amiguser/pcb/template_atmega8/description.odt

Возможности

Тактирование (переключатель):

- Внутренний
- Внешний 8МГц

i2c – линия

RX-TX – линия

Входы аналоговые

Управление – кнопки\клавиатура.

Отображение – 7-сегментный, 1603 – дисплей.

Сигнализация – светодиоды, бузер.

Ввод – кнопки:

PB0-PB3

Вывод – leds:

PB5-PB7

Вывод – buzzer:

PB4
