amiguser/pcb/waterlock/controllerTFQP.ods

Id | Designator | Package | Quantity | Designation | Supplier and ref | Total | pads/driils | type
1 | R7,R8 | R_0805_HandSoldering | 2 | 10k | 0,8 | 1,6 | 2 | smd | 4
2 | BZ1 | Buzzer_12x9.5RM7.6 | 1 | Buzzer | 8 | 8 | 2 | th | 2
3 | C1,C3 | C_1206_HandSoldering | 2 | 10m | 1 | 2 | 2 | smd | 4
4 | D1 | D_SMA_Handsoldering | 2 | SS16 | 2 | 4 | 2 | smd | 4
5 | D3 | LED_D3.0mm | 1 | LowBatt | 1 | 1 | 2 | th | 2
6 | D4 | LED_D3.0mm | 1 | Flooding | 1 | 1 | 2 | th | 2
7 | J8 | Pin_Header_Straight_1x06_Pitch2.54mm | 1 | Conn_01x06 | 0,6 | 0,6 | 6 | th | 6
8 | R1,R4,R5,R6,R2,R3 | R_1206_HandSoldering | 6 | 10k | 0,8 | 4,8 | 2 | smd | 12
9 | SW1 | SW_Tactile_SPST_Angled_PTS645Vx39-2LFS | 1 | Tactile Angle | 2 | 2 | 4 | th | 4
10 | U1 | TQFP-32_7x7mm_Pitch0.8mm | 1 | ATMEGA8-16PU | 42 | 42 | 32 | smd | 32
11 | U3 | DIP-16_W7.62mm | 1 | L293D | 17 | 17 | 16 | th | 16
12 | D5,D6 | D_SMA | 2 | D_ALT | 2 | 4 | 2 | smd | 4
13 | D7,D8 | D_DO-15_P10.16mm_Horizontal | 2 | 1N5822 | 2 | 4 | 2 | th | 4
14 | J3,J4 | TerminalBlock_Philmore_TB133_03x5mm_Straight | 2 | 300-031-7,5 | 5,7 | 11,4 | 3 | th | 6
15 | J6,J7 | TerminalBlock_Philmore_TB132_02x5mm_Straight | 2 | 301-021-12 | 3,5 | 7 | 2 | th | 4
16 | R9,R10 | R_0805_HandSoldering | 2 | 1k | 0,8 | 1,6 | 2 | smd | 4
17 | U2 | SOIC-8_3.9x4.9mm_Pitch1.27mm | 1 | DS1307+ | 4,2 | 4,2 | 8 | smd | 8
18 | U4,U5 | DIP-4_W7.62mm | 2 | PC817 | 4 | 8 | 4 | th | 8
19 | Y1 | Crystal_C38-LF_d3.0mm_l8.0mm_Horizontal_1EP_style2 | 1 | 32768Hz | 4 | 4 | 2 | th | 2
20 | PCB |  | 1 |  | 68 | 68 |  |  | 0
 | Assemble |  | 1 |  | 248 | 248 |  |  | 0
 | Case |  | 1 |  | 100 | 100 |  |  | 0
 | Total |  |  |  |  | 544,2 |  |  |  | price
 |  |  |  |  |  |  | SMD | 18 | 72 | 1,5 | 108
 |  |  |  |  |  |  | TH | 15 | 56 | 2,5 | 140
 |  |  |  | Контроллер | 500 |  |  |  |  |  | 248
 |  |  |  | Valve | 1700
 |  |  |  | sensor | 150
 |  |  |  | sales | 1200
 |  |  |  | Total: | 3550
 |  |  |  | Price | 8050
 |  |  |  | Profit | 4500
