amiguser/pcb/fitotimer/pcb-01/pcb-01.ods

Source: | /home/mih/ownCloud/gr/FitoTimer/pcb-01/pcb-01.sch
Date: | Пн 26 фев 2018 16:01:38
Tool: | Eeschema 4.0.7-e2-6376~58~ubuntu16.04.1
Component Count: | 12
Ref | Value | Footprint | Datasheet | Manufacturer | Vendor
BT1 | 3V | Batteries:BATTCOM_20MM_PTH |  |  | 5
C1 | 1.0UF | 1206 |  |  | 1
C2 | 22mF | Capacitors_ThroughHole:CP_Radial_D6.3mm_P2.50mm |  |  | 7
D1 | DIODE-PTH | DIODE-1N4001 |  |  | 7
J1 | Screw_Terminal_01x02 | Connectors_Terminal_Blocks:TerminalBlock_Pheonix_MKDS1.5-2pol |  |  | 5.5
P1 | RELAY831-1A | mih-library:Relay-841-1A |  |  | 24
Q1 | BC547 | TO_SOT_Packages_THT:TO-92_Molded_Narrow |  |  | 1.5
R1 | RESISTOR1206 | 1206 |  |  | 0.8
U1 | ATMEGA8-16AU | Housings_QFP:TQFP-32_7x7mm_Pitch0.8mm |  |  | 36
U2 | NRF24L01 | NRF24L01 |  |  | 50
U3 | DS1307Z | Housings_SOIC:SOIC-8_3.9x4.9mm_Pitch1.27mm |  |  | 7
Y1 | Crystal | Crystals:Crystal_C38-LF_d3.0mm_l8.0mm_Horizontal_1EP_style2 |  |  | 4
 |  |  |  |  | 60
 |  |  |  |  | 208.8
