amiguser/pcb/CE3_gear.stl

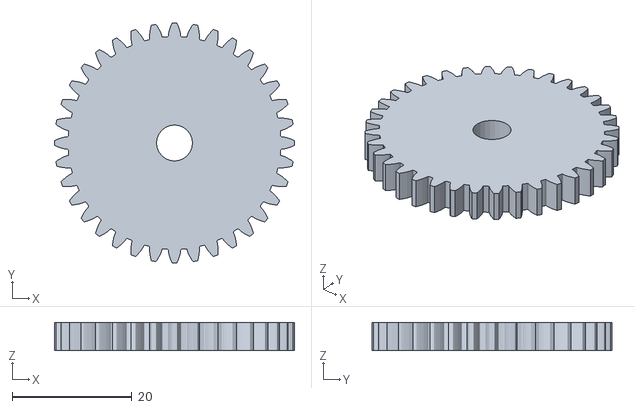
[picture p1: CAD file, 2018-11-02]
CE3_gear.stl
40.0 x 40.0 x 4.74
