amiguser/pcb/(list of files, cad)

Other CAD files:
gear.skp
teplica01.skp
waterlock/case-01.skp
