amiguser/pcb/amp_tea2025/amp_tea2025-B.Cu.pdf

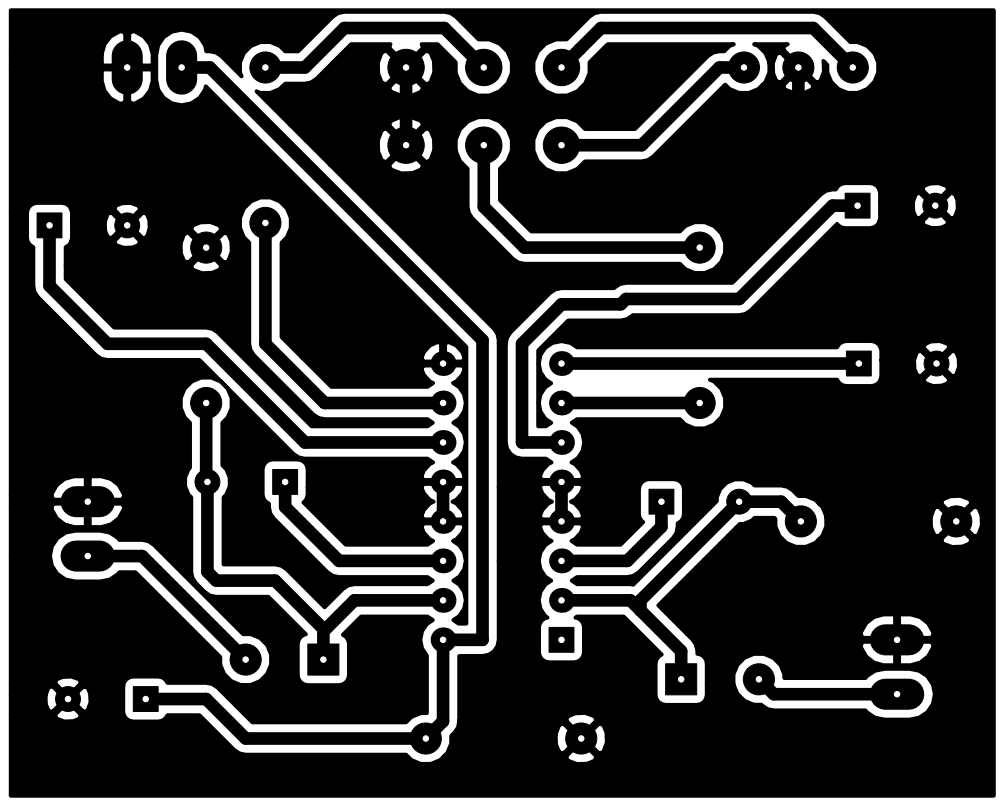
[picture p2: page 1]
