amiguser/pcb/disp_7221/pdf/disp_7221-B.Cu.pdf

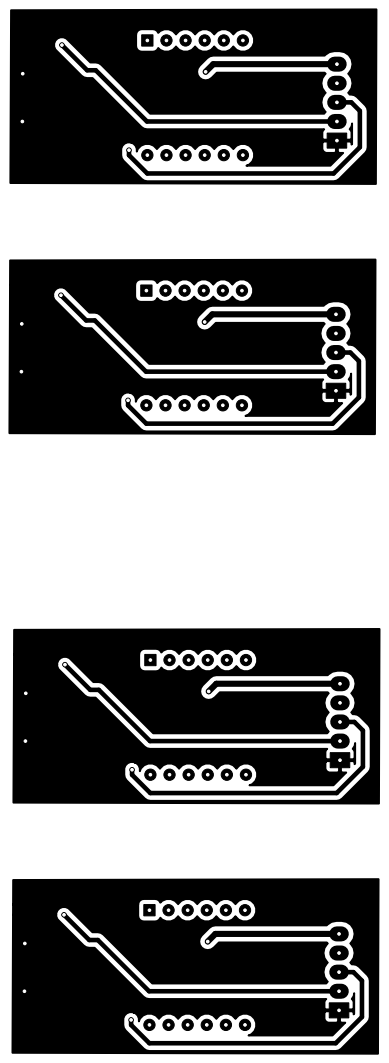
[picture p3: page 1]
