amiguser/pcb/disp_7221/pdf/disp_7221-F.Cu-mod.pdf

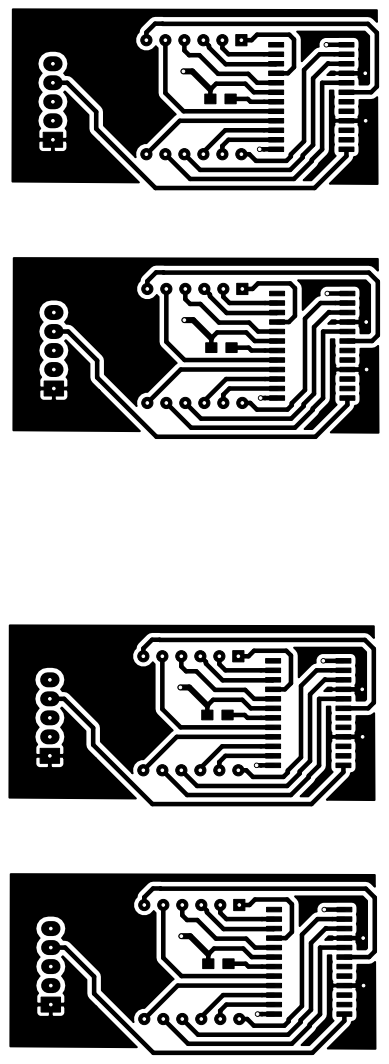
[picture p4: page 1]
