amiguser/pcb/(list of files, drawings)

Other design files:
proteus_lsensor.pdsprj
