amiguser/pcb/waterlock/controllerTFQP.kicad_pcb

## KiCad design waterlock/controllerTFQP.kicad_pcb (2018-12-29)

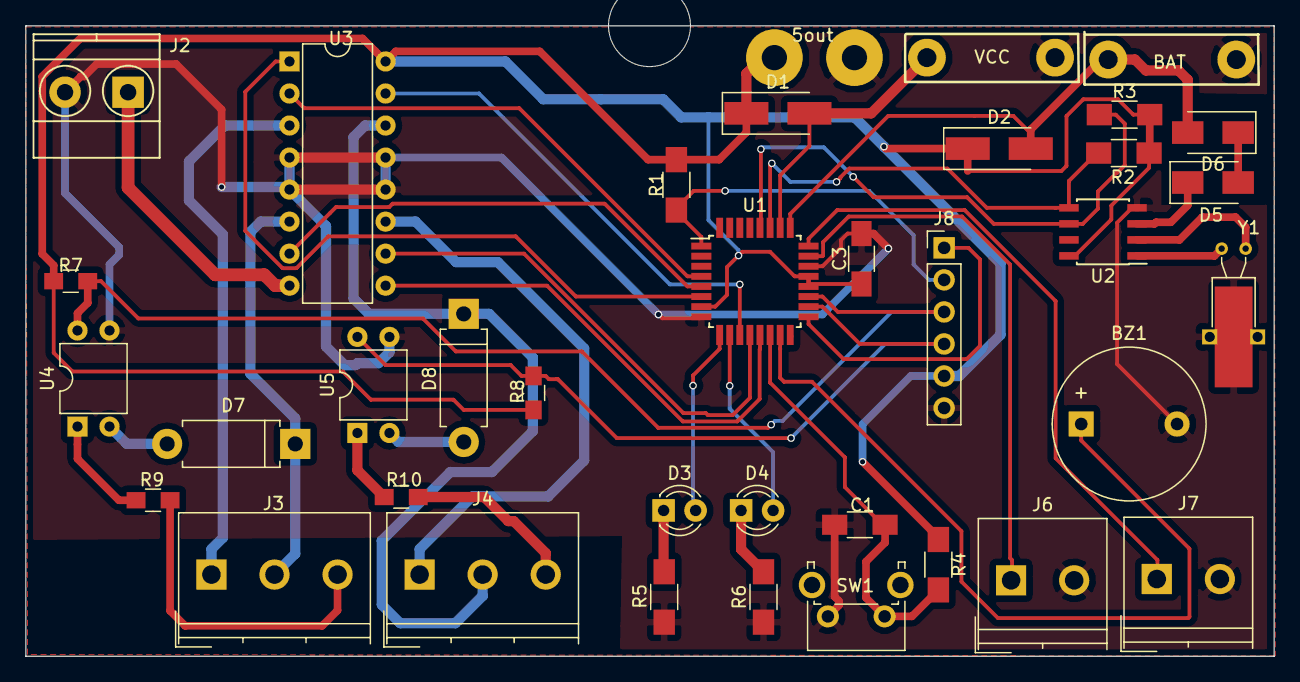
[picture p5: board controllerTFQP.kicad_pcb from above]

Board: 2 copper layers, 99.0 x 50.0 mm, 37 parts (0 on the bottom side), 39 nets.

Parts:
5out: SolderWirePad_2x_2mmDrill
BAT: Battery; WireConnection_1.50mmDrill
BZ1: Buzzer; Buzzer_12x9.5RM7.6
C1, C3: 10m; C_1206_HandSoldering
D1: SS16; D_SMA_Handsoldering
D2: 1N; D_SMA_Handsoldering
D3: LowBatt; LED_D3.0mm
D4: Flooding; LED_D3.0mm
D5, D6: D_ALT; D_SMA
D7, D8: 1N5822; D_DO-15_P10.16mm_Horizontal
J2: v12; TerminalBlock_Pheonix_MKDS1.5-2pol
J3, J4: 300-031-7,5; TerminalBlock_Philmore_TB133_03x5mm_Straight
J6, J7: 301-021-12; TerminalBlock_Philmore_TB132_02x5mm_Straight
J8: Conn_01x06; Pin_Header_Straight_1x06_Pitch2.54mm
R1, R2, R3, R4, R5, R6: 10k; R_1206_HandSoldering
R7, R8: 10k; R_0805_HandSoldering
R9, R10: 1k; R_0805_HandSoldering
SW1: Tactile Angle; SW_Tactile_SPST_Angled_PTS645Vx39-2LFS
U1: ATMEGA8-16PU; TQFP-32_7x7mm_Pitch0.8mm
U2: DS1307+; SOIC-8_3.9x4.9mm_Pitch1.27mm
U3: L293D; DIP-16_W7.62mm
U4, U5: PC817; DIP-4_W7.62mm
VCC: v5; WireConnection_1.50mmDrill
Y1: 32768Hz; Crystal_C38-LF_d3.0mm_l8.0mm_Horizontal_1EP_style2

Connections:
+5V: 5out.1, C3.1, D1.1, D2.1, J8.5, R1.1, R2.2, R3.2, R4.1, R7.2, R8.2, U1.7, U1.20, U1.21, U2.8, U3.16
/Line1: J6.1, U1.23
/Line2: J7.1, U1.24
/MISO: J8.4, R8.1, U1.18, U5.4
/MOSI: J8.1, U1.17
/MotorsShield/m1black: D7.1, J3.2, U3.6
/MotorsShield/m1sensor: J3.3, R9.1
/MotorsShield/m2black: D8.1, J4.2, U3.14
/MotorsShield/m2sensor: J4.3, R10.1
/RESET: J8.2, R1.2, U1.1
/SCK: J8.3, R7.1, U1.19, U4.4
/SCL: R3.1, U1.28, U2.6
/SDA: R2.1, U1.27, U2.5
/btn_1: C1.2, R4.2, SW1.1, U1.14
/buzz: BZ1.1, U1.15
/en12: U1.6, U3.1
/en34: U1.13, U3.9
/led1: D3.2, U1.9
/led2: D4.2, U1.10
/m1a: U1.4, U3.2
/m2a: U1.5, U3.7
/m3a: U1.12, U3.10
/m4a: U1.11, U3.15
/pwr_c1: BAT.1, D2.2, D6.2, U1.25
/pwr_c2: D1.2, U1.26, VCC.1
GND: 5out.1, BAT.2, BZ1.2, C1.1, C3.2, J2.2, J6.2, J7.2, J8.6, R5.2, R6.2, SW1.2, U1.8, U1.22, U2.4, U3.4, U3.5, U3.12, U3.13, U4.3, U5.3, VCC.2, Y1.3
unnamed: D3.1, R5.1
unnamed: D4.1, R6.1
unnamed: D5.1, U2.3
unnamed: D5.2, D6.1
unnamed: D7.2, U4.2
unnamed: D8.2, U5.2
unnamed: J2.1, U3.8
unnamed: J3.1, U3.3
unnamed: J4.1, U3.11
unnamed: R9.2, U4.1
unnamed: R10.2, U5.1
unnamed: U2.1, Y1.1
unnamed: U2.2, Y1.2
