amiguser/pcb/Усилитель1557q/Усилитель1557q.kicad_pcb

## KiCad design Усилитель1557q/Усилитель1557q.kicad_pcb (2018-08-15)

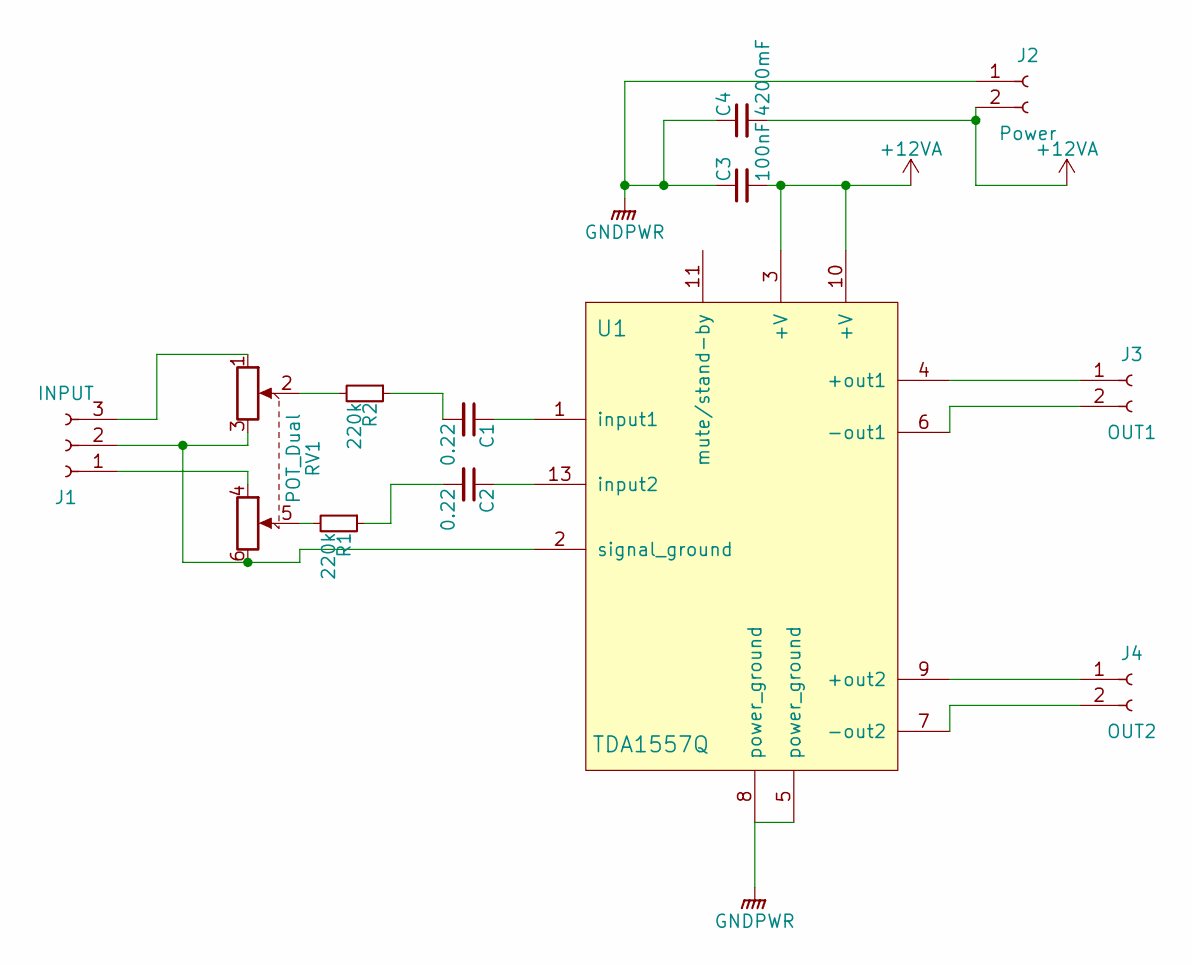
[picture p6: schematic Усилитель1557q.sch]

Parts:
C1, C2: 0.22; C_Disc_D11.0mm_W5.0mm_P7.50mm
C3: 100nF; C_Disc_D11.0mm_W5.0mm_P7.50mm
C4: 4200mF; CP_Radial_D13.0mm_P5.00mm
J1: INPUT; TerminalBlock_Pheonix_MKDS1.5-3pol
J2: Power; TerminalBlock_Pheonix_MKDS1.5-2pol
J3: OUT1; TerminalBlock_Pheonix_MKDS1.5-2pol
J4: OUT2; TerminalBlock_Pheonix_MKDS1.5-2pol
R1, R2: 220k; R_Axial_DIN0204_L3.6mm_D1.6mm_P7.62mm_Horizontal
RV1: POT_Dual; Potentiometer_Alps_RK163_Double_Vertical
U1: TDA1557Q; Multiwatt_15_Vertical

Connections:
+12VA: C3.2, C4.2, J2.2, U1.3 (+V), U1.10 (+V)
GNDPWR: C3.1, C4.1, J2.1, U1.5 (power_ground), U1.8 (power_ground)
unnamed: C1.1, U1.1 (input1)
unnamed: C1.2, R2.1
unnamed: C2.1, U1.13 (input2)
unnamed: C2.2, R1.1
unnamed: J1.1, RV1.4
unnamed: J1.2, RV1.3, RV1.6, U1.2 (signal_ground)
unnamed: J1.3, RV1.1
unnamed: J3.1, U1.4 (+out1)
unnamed: J3.2, U1.6 (-out1)
unnamed: J4.1, U1.9 (+out2)
unnamed: J4.2, U1.7 (-out2)
unnamed: R1.2, RV1.5
unnamed: R2.2, RV1.2

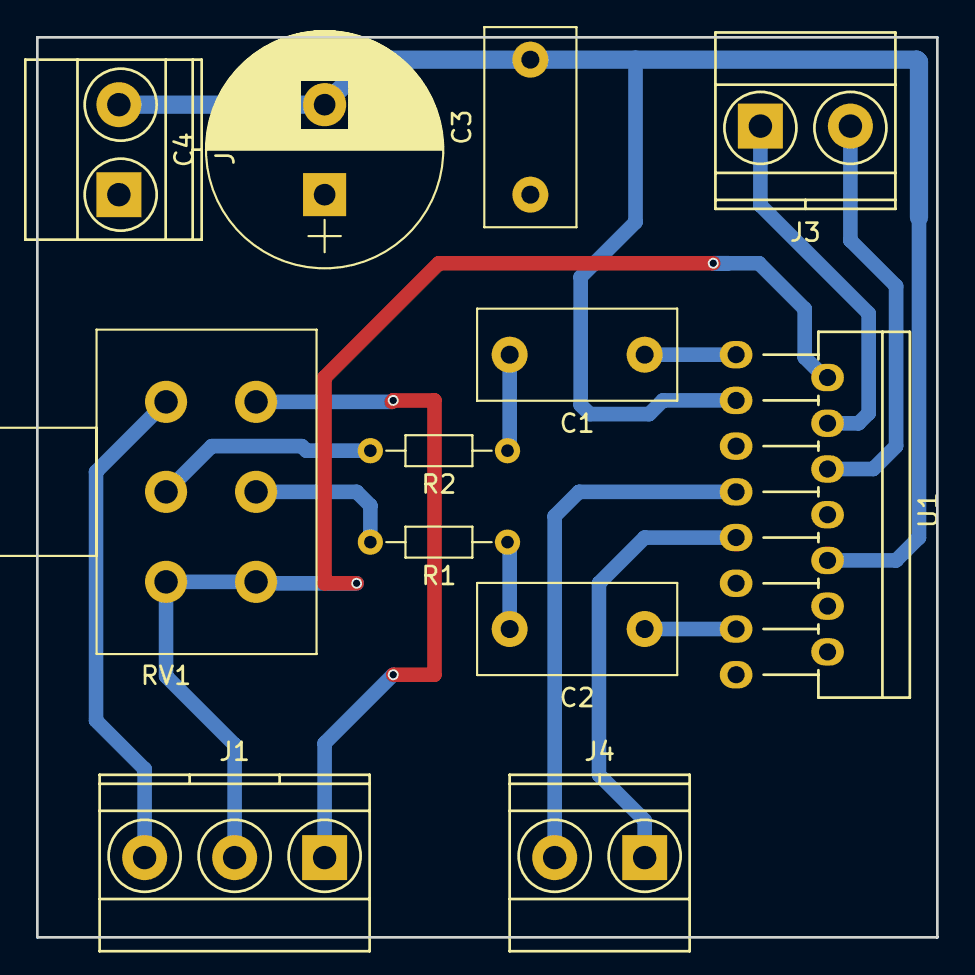
[picture p7: board Усилитель1557q.kicad_pcb from above]

Board: 2 copper layers, 50.0 x 50.0 mm, 12 parts (0 on the bottom side), 15 nets.
