amiguser/pcb/i2c_portexpander/i2c_portexpander.kicad_pcb

## KiCad design i2c_portexpander/i2c_portexpander.kicad_pcb (2018-08-07)

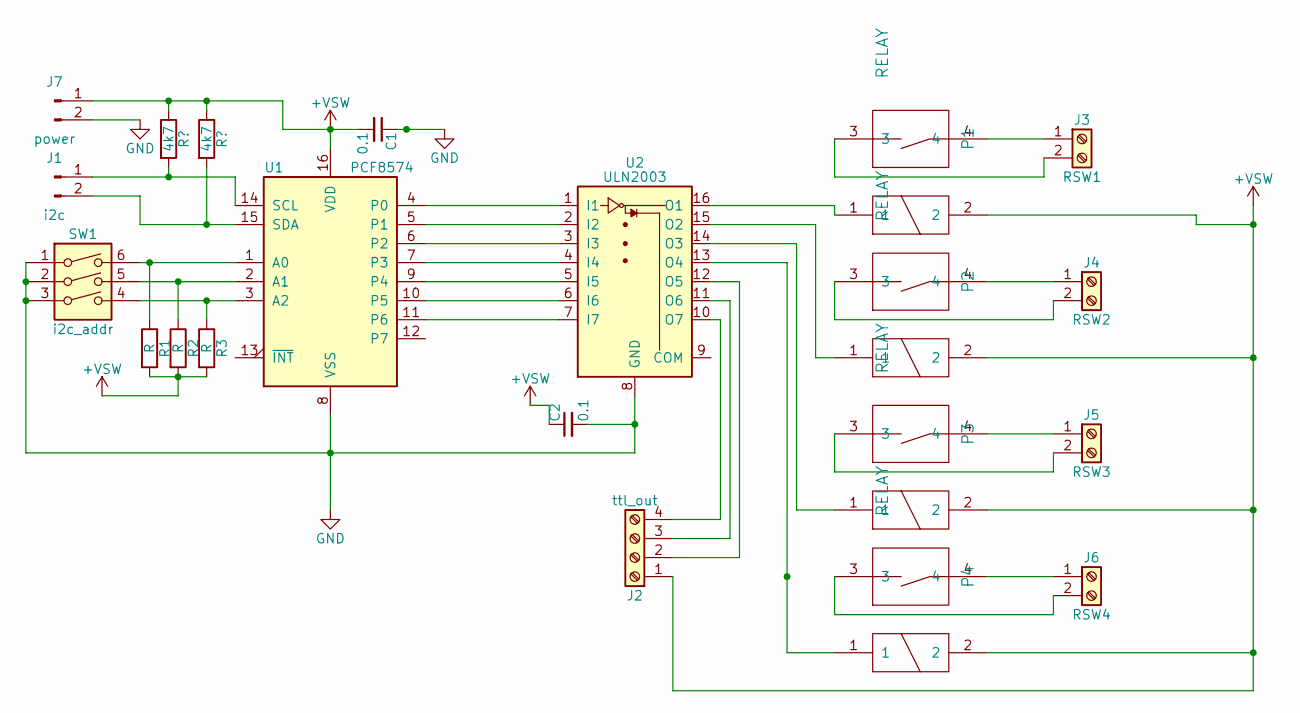
[picture p8: schematic i2c_portexpander.sch]

Parts:
C1, C2: 0.1; C_1206_HandSoldering
J1: i2c; Molex_KK-6410-02_02x2.54mm_Straight
J2: ttl_out; WAGO_734_4pin_Straight
J3: RSW1; TerminalBlock_Pheonix_MKDS1.5-2pol
J4: RSW2; TerminalBlock_Pheonix_MKDS1.5-2pol
J5: RSW3; TerminalBlock_Pheonix_MKDS1.5-2pol
J6: RSW4; TerminalBlock_Pheonix_MKDS1.5-2pol
J7: power; Molex_KK-6410-02_02x2.54mm_Straight
P1, P2, P3, P4: RELAY; Relay-841-1A
R1, R2, R3: R; R_0805_HandSoldering
SW1: i2c_addr; SW_DIP_x3_W8.61mm_Slide_LowProfile
U1: PCF8574; SOIC-16W_7.5x10.3mm_Pitch1.27mm
U2: ULN2003; SOIC-16W_5.3x10.2mm_Pitch1.27mm

Connections:
+VSW: C1.2, C2.1, J2.1, J7.1, P1.2, P2.2, P3.2, P4.2, R1.2, R2.2, R3.2, U1.16 (VDD); also elsewhere on the board
GND: C1.1, C2.2, J7.2, SW1.1, SW1.2, SW1.3, U1.8 (VSS), U2.8 (GND)
unnamed 2: J1.1, U1.14 (SCL); also elsewhere on the board
unnamed 3: J1.2, U1.15 (SDA); also elsewhere on the board
unnamed: J2.2, U2.12 (O5)
unnamed: J2.3, U2.11 (O6)
unnamed: J2.4, U2.10 (O7)
unnamed: J3.1, P1.4
unnamed: J3.2, P1.3
unnamed: J4.1, P2.4
unnamed: J4.2, P2.3
unnamed: J5.1, P3.4
unnamed: J5.2, P3.3
unnamed: J6.1, P4.4
unnamed: J6.2, P4.3
unnamed: P1.1, U2.16 (O1)
unnamed: P2.1, U2.15 (O2)
unnamed: P3.1, U2.14 (O3)
unnamed: P4.1, U2.13 (O4)
unnamed: R1.1, SW1.6, U1.1 (A0)
unnamed: R2.1, SW1.5, U1.2 (A1)
unnamed: R3.1, SW1.4, U1.3 (A2)
unnamed: U1.4 (P0), U2.1 (I1)
unnamed: U1.5 (P1), U2.2 (I2)
unnamed: U1.6 (P2), U2.3 (I3)
unnamed: U1.7 (P3), U2.4 (I4)
unnamed: U1.9 (P4), U2.5 (I5)
unnamed: U1.10 (P5), U2.6 (I6)
unnamed: U1.11 (P6), U2.7 (I7)

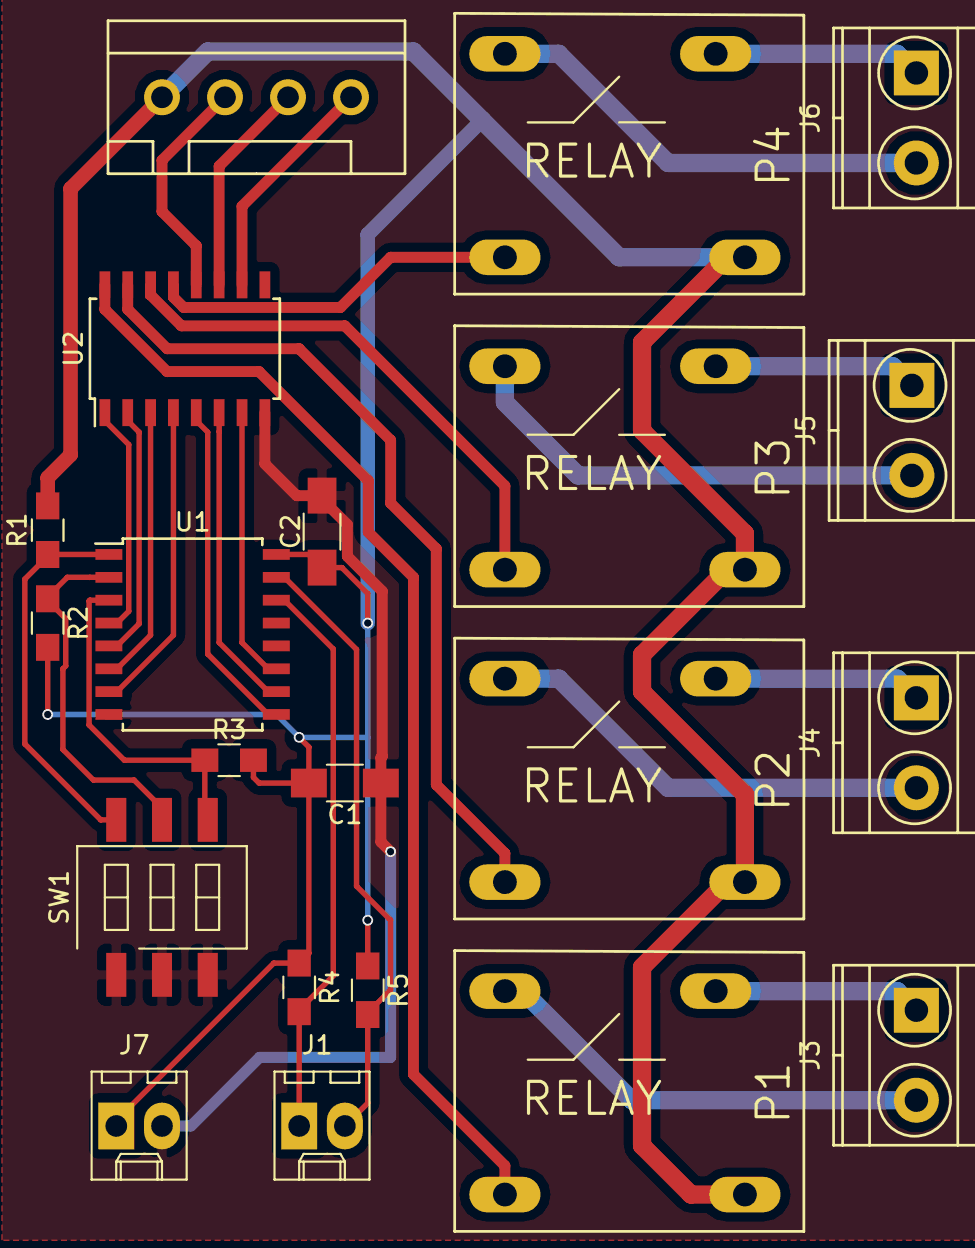
[picture p9: board i2c_portexpander.kicad_pcb from above]

Board: 2 copper layers, 21 parts (0 on the bottom side), 29 nets.

Other parts of the board:
R4, R5: 4k7; R_0805_HandSoldering

Their connections:
+VSW: R4.1, R5.1; also elsewhere on the board
unnamed 2: R4.2; also elsewhere on the board
unnamed 3: R5.2; also elsewhere on the board
