amiguser/pcb/fitotimer/v01.kicad_pcb

## KiCad design fitotimer/v01.kicad_pcb (2018-08-03)

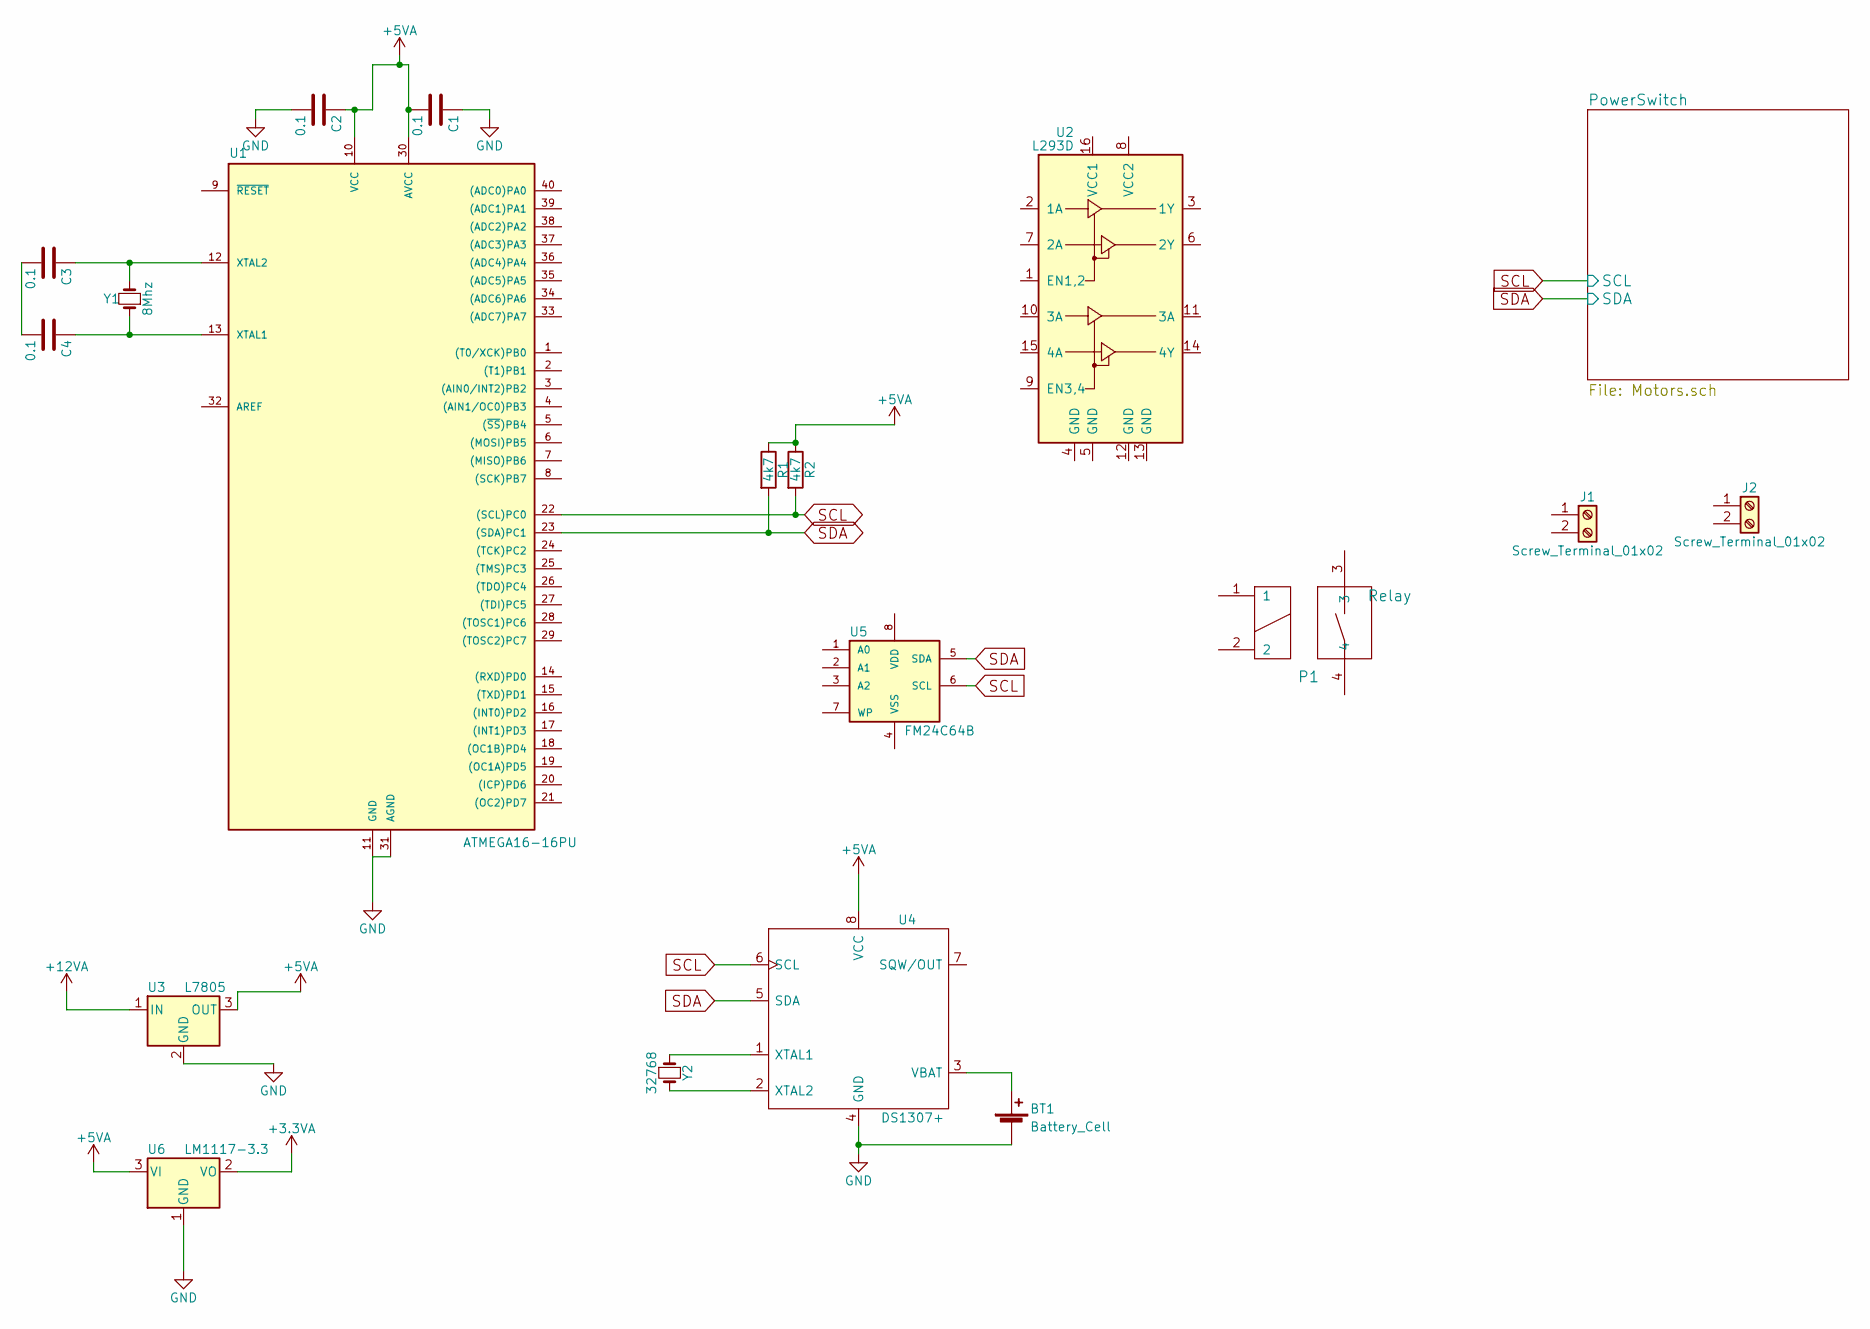
[picture p10: schematic v01.sch]

Parts:
BT1: Battery_Cell; BATTCOM_20MM_PTH
C1, C2: 0.1; C_Disc_D5.1mm_W3.2mm_P5.00mm
C3, C4: 0.1; C_Disc_D3.8mm_W2.6mm_P2.50mm
J1, J2: Screw_Terminal_01x02; TerminalBlock_Pheonix_PT-3.5mm_2pol
P1: Relay; Relay-841-1A
R1, R2: 4k7; R_0805_HandSoldering
U1: ATMEGA16-16PU; DIP-40_W15.24mm_LongPads
U2: L293D; DIP-16_W7.62mm
U3: L7805; TO-220_Neutral123_Vertical_LargePads
U4: DS1307+; SOIC-8_3.9x4.9mm_Pitch1.27mm
U5: FM24C64B
U6: LM1117-3.3; SOT-223
Y1: 8Mhz; Crystal_HC49-4H_Vertical
Y2: 32768; Crystal_C38-LF_d3.0mm_l8.0mm_Horizontal_1EP_style2

Connections:
+3.3VA: U6.2 (VO)
+5VA: C1.2, C2.1, R1.1, R2.1, U1.10 (VCC), U1.30 (AVCC), U3.3 (OUT), U4.8 (VCC), U6.3 (VI); also elsewhere on the board
+12VA: U3.1 (IN)
GND: BT1.2 (-), C1.1, C2.2, U1.11 (GND), U1.31 (AGND), U3.2 (GND), U4.4 (GND), U6.1 (GND); also elsewhere on the board
unnamed: BT1.1 (+), U4.3 (VBAT)
unnamed: C3.1, U1.12 (XTAL2), Y1.2
unnamed: C3.2, C4.2
unnamed: C4.1, U1.13 (XTAL1), Y1.1
unnamed: U4.1 (XTAL1), Y2.1
unnamed: U4.2 (XTAL2), Y2.2
SCL: R2.2, U1.22 ((SCL)PC0), U4.6 (SCL), U5.6 (SCL); also elsewhere on the board
SDA: R1.2, U1.23 ((SDA)PC1), U4.5 (SDA), U5.5 (SDA); also elsewhere on the board

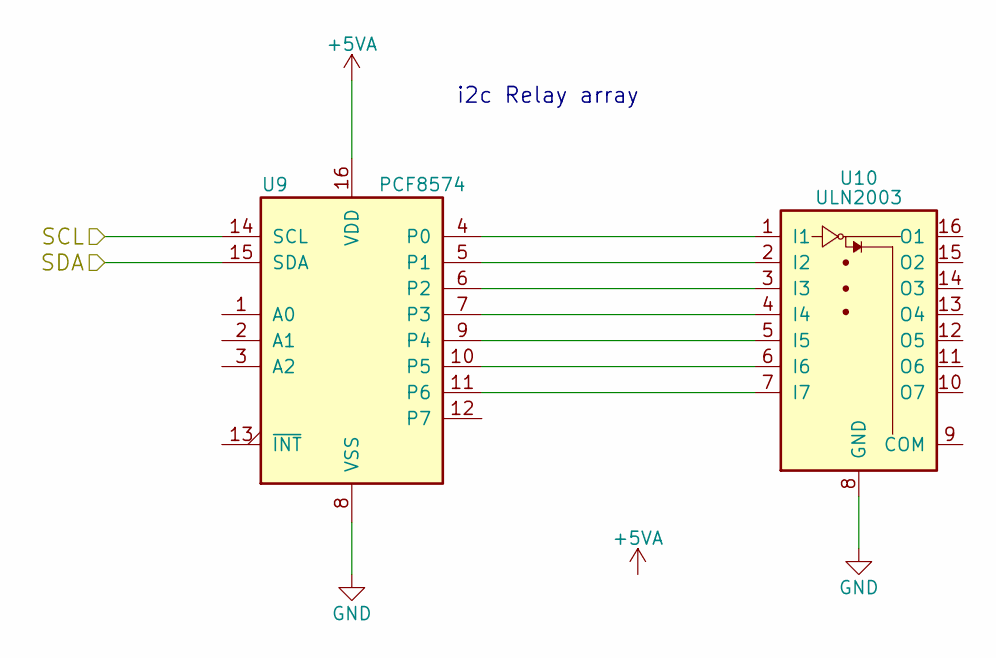
[picture p11: schematic Motors.sch]

Parts:
U9: PCF8574; SOIC-16_3.9x9.9mm_Pitch1.27mm
U10: ULN2003; DIP-16_W7.62mm

Connections:
+5VA: U9.16 (VDD); also elsewhere on the board
GND: U9.8 (VSS), U10.8 (GND); also elsewhere on the board
unnamed: U9.4 (P0), U10.1 (I1)
unnamed: U9.5 (P1), U10.2 (I2)
unnamed: U9.6 (P2), U10.3 (I3)
unnamed: U9.7 (P3), U10.4 (I4)
unnamed: U9.9 (P4), U10.5 (I5)
unnamed: U9.10 (P5), U10.6 (I6)
unnamed: U9.11 (P6), U10.7 (I7)
SCL: U9.14 (SCL); also elsewhere on the board
SDA: U9.15 (SDA); also elsewhere on the board

Notes on the sheet:
i2c Relay array

Board: 2 copper layers, 19 parts (0 on the bottom side), 17 nets, no tracks yet.
