amiguser/pcb/amp_tea2025/amp_tea2025.kicad_pcb

## KiCad design amp_tea2025/amp_tea2025.kicad_pcb (2018-08-03)

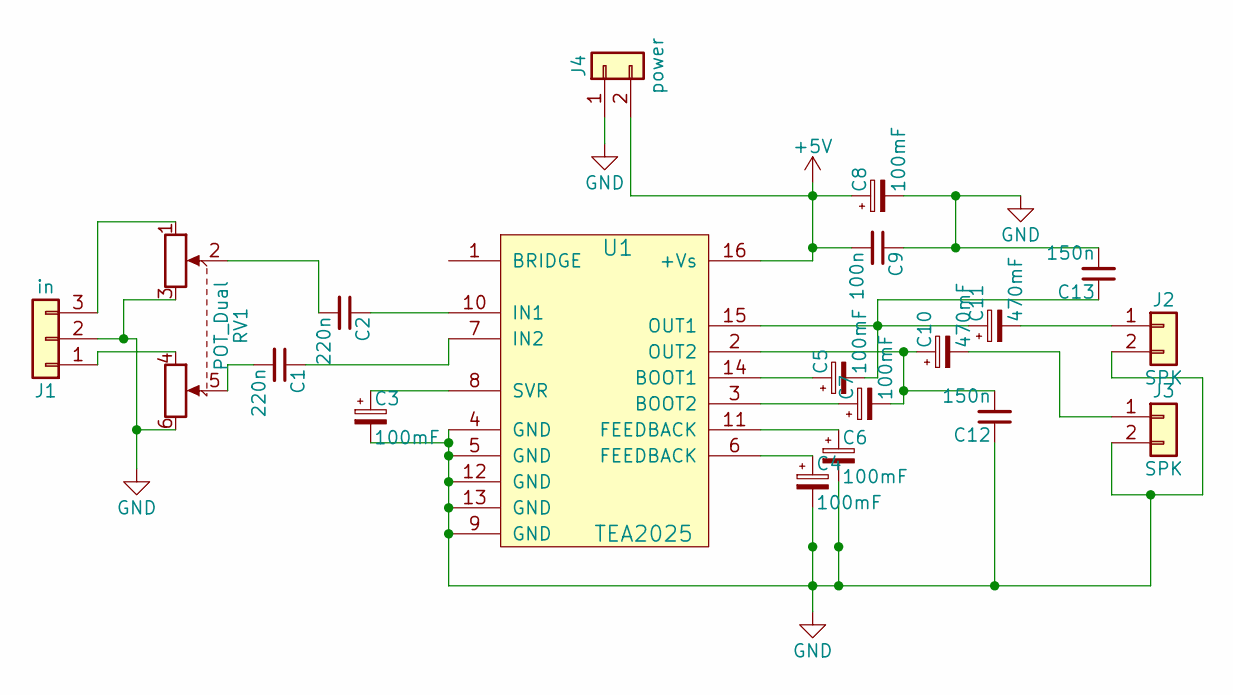
[picture p12: schematic amp_tea2025.sch]

Parts:
C1, C2: 220n; C_Disc_D9.0mm_W5.0mm_P10.00mm
C3, C4, C5, C6, C7, C8: 100mF; CP_Radial_D8.0mm_P5.00mm
C9: 100n; C_Disc_D9.0mm_W5.0mm_P10.00mm
C10, C11: 470mF; CP_Radial_D10.0mm_P5.00mm
C12, C13: 150n; C_Disc_D9.0mm_W5.0mm_P10.00mm
J1: in; WAGO_734_3pin_Straight
J2, J3: SPK; WAGO_734_2pin_Straight_RuggedPads
J4: power; WAGO_734_2pin_Straight_RuggedPads
RV1: POT_Dual; Potentiometer_Alps_RK163_Double_Vertical
U1: TEA2025; DIP-16_W7.62mm

Connections:
+5V: C8.1, C9.2, J4.2, U1.16 (+Vs)
GND: C3.2, C4.2, C6.2, C8.2, C9.1, C12.1, C13.2, J1.2, J2.2, J3.2, J4.1, RV1.3, RV1.6, U1.4 (GND), U1.5 (GND), U1.9 (GND), U1.12 (GND), U1.13 (GND)
unnamed: C1.1, U1.7 (IN2)
unnamed: C1.2, RV1.5
unnamed: C2.1, U1.10 (IN1)
unnamed: C2.2, RV1.2
unnamed: C3.1, U1.8 (SVR)
unnamed: C4.1, U1.6 (FEEDBACK)
unnamed: C5.1, U1.14 (BOOT1)
unnamed: C6.1, U1.11 (FEEDBACK)
unnamed: C7.1, U1.3 (BOOT2)
unnamed: C7.2, C10.1, C12.2, U1.2 (OUT2)
unnamed: C10.2, J3.1
unnamed: C5.2, C11.1, C13.1, U1.15 (OUT1)
unnamed: C11.2, J2.1
unnamed: J1.1, RV1.4
unnamed: J1.3, RV1.1

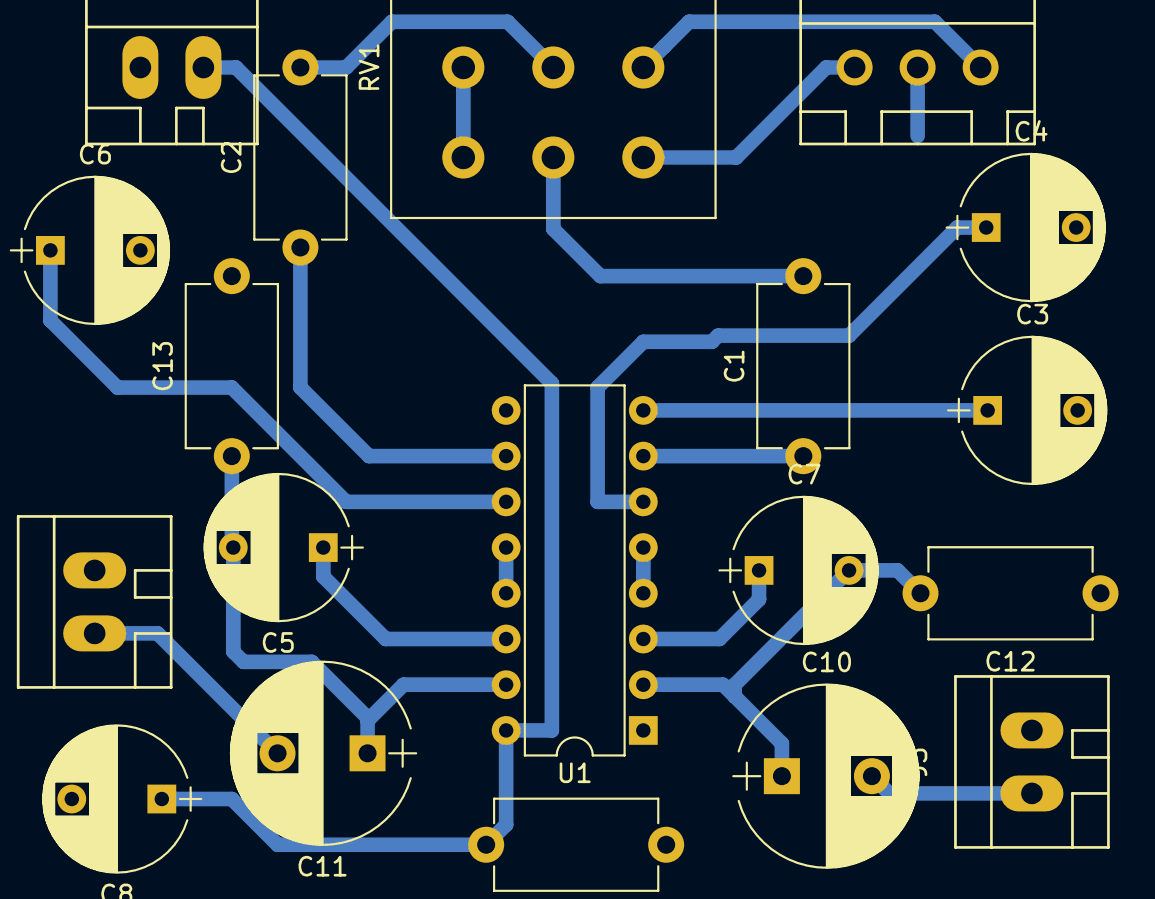
[picture p13: board amp_tea2025.kicad_pcb from above]

Board: 2 copper layers, 19 parts (0 on the bottom side), 17 nets.
