amiguser/pcb/disp_7221/disp_7221.kicad_pcb

## KiCad design disp_7221/disp_7221.kicad_pcb (2018-07-30)

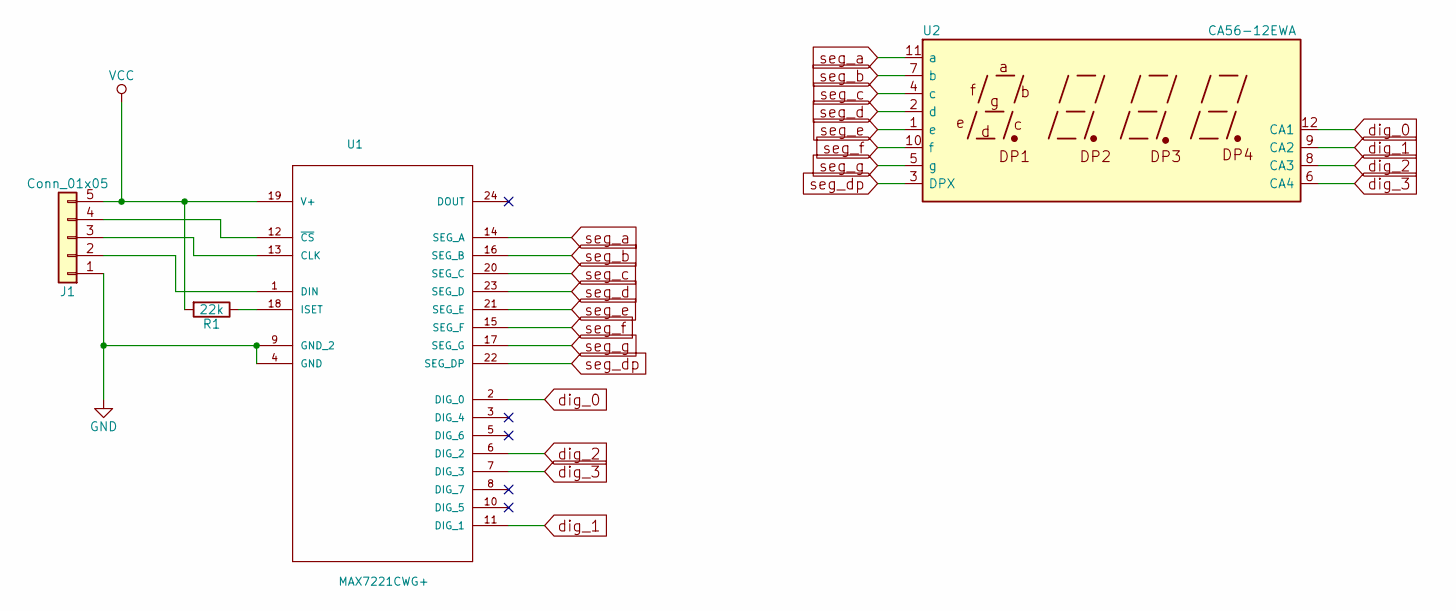
[picture p14: schematic disp_7221.sch]

Parts:
J1: Conn_01x05; Molex_KK-6410-05_05x2.54mm_Straight
R1: 22k; R_0805_HandSoldering
U1: MAX7221CWG+; SOIC-24_7.5x15.4mm_Pitch1.27mm
U2: CA56-12EWA; Cx56-12

Connections:
GND: J1.1, U1.4 (GND), U1.9 (GND_2)
unnamed: J1.2, U1.1 (DIN)
unnamed: J1.3, U1.13 (CLK)
unnamed: J1.4, U1.12 (~CS)
unnamed: R1.1, U1.18 (ISET)
VCC: J1.5, R1.2, U1.19 (V+)
dig_0: U1.2 (DIG_0), U2.12 (CA1)
dig_1: U1.11 (DIG_1), U2.9 (CA2)
dig_2: U1.6 (DIG_2), U2.8 (CA3)
dig_3: U1.7 (DIG_3), U2.6 (CA4)
seg_a: U1.14 (SEG_A), U2.11 (a)
seg_b: U1.16 (SEG_B), U2.7 (b)
seg_c: U1.20 (SEG_C), U2.4 (c)
seg_d: U1.23 (SEG_D), U2.2 (d)
seg_dp: U1.22 (SEG_DP), U2.3 (DPX)
seg_e: U1.21 (SEG_E), U2.1 (e)
seg_f: U1.15 (SEG_F), U2.10 (f)
seg_g: U1.17 (SEG_G), U2.5 (g)

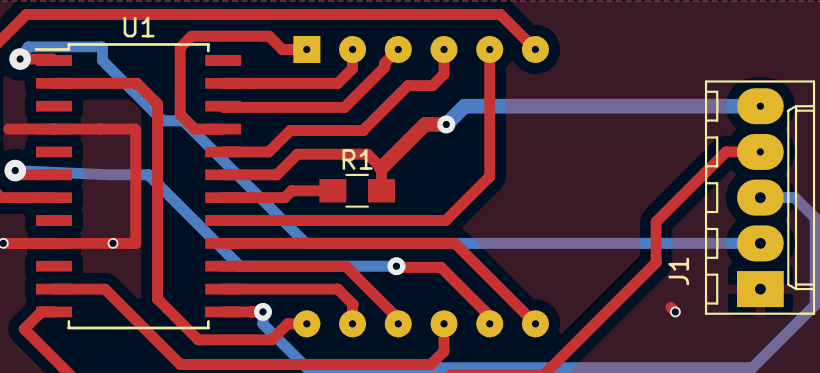
[picture p15: board disp_7221.kicad_pcb from above]

Board: 2 copper layers, 4 parts (1 on the bottom side), 18 nets.
