amiguser/pcb/disp_1628/disp_1628.kicad_pcb

## KiCad design disp_1628/disp_1628.kicad_pcb (2018-07-30)

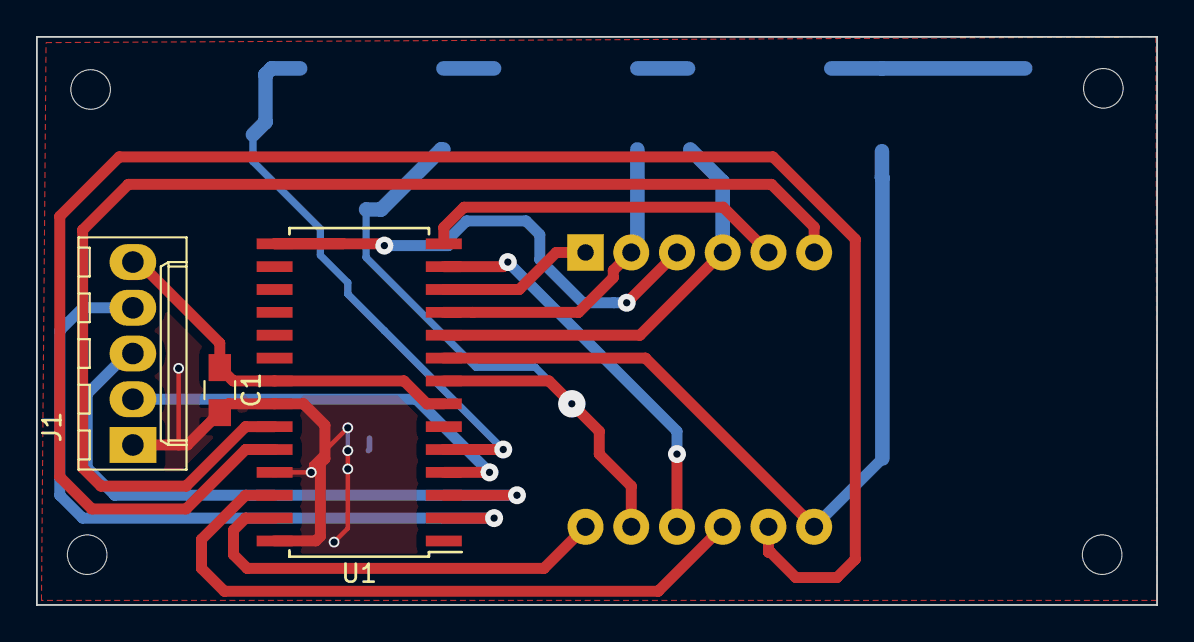
[picture p16: board disp_1628.kicad_pcb from above]

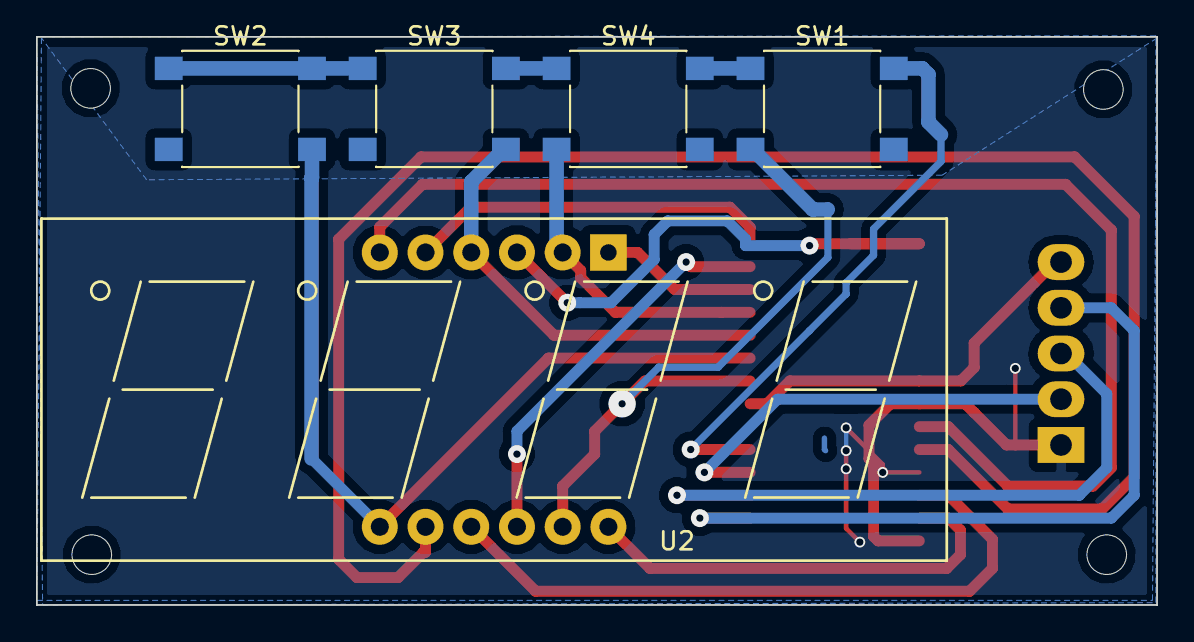
[picture p17: board disp_1628.kicad_pcb from below]

Board: 2 copper layers, 62.2 x 31.6 mm, 8 parts (5 on the bottom side), 18 nets.

Parts:
C1: 0.1; C_0805_HandSoldering
J1: Conn_01x05; Molex_KK-6410-05_05x2.54mm_Straight
SW1, SW2, SW3, SW4: SW_Push; SW_SPST_PTS645
U1: TM1628; SOIC-28W_7.5x17.9mm_Pitch1.27mm
U2: CA56-12EWA; Cx56-12

Connections:
GND: C1.2, J1.1, U1.22, U1.25, U1.28
K1: SW1.1, SW2.1, SW3.1, SW4.1, U1.5
unnamed: J1.2, U1.4
unnamed: J1.3, U1.3
unnamed: J1.4, U1.2
VCC: C1.1, J1.5, U1.7, U1.21
dig_0: U1.27, U2.12
dig_1: U1.26, U2.9
dig_2: U1.24, U2.8
dig_3: U1.23, U2.6
seg_a: SW1.2, U1.8, U2.11
seg_b: SW2.2, U1.9, U2.7
seg_c: SW3.2, U1.10, U2.4
seg_d: SW4.2, U1.11, U2.2
seg_dp: U1.15, U2.3
seg_e: U1.12, U2.1
seg_f: U1.13, U2.10
seg_g: U1.14, U2.5
