amiguser/pcb/leakage_sensort/v01.kicad_pcb

## KiCad design leakage_sensort/v01.kicad_pcb (2018-07-30, an earlier design)

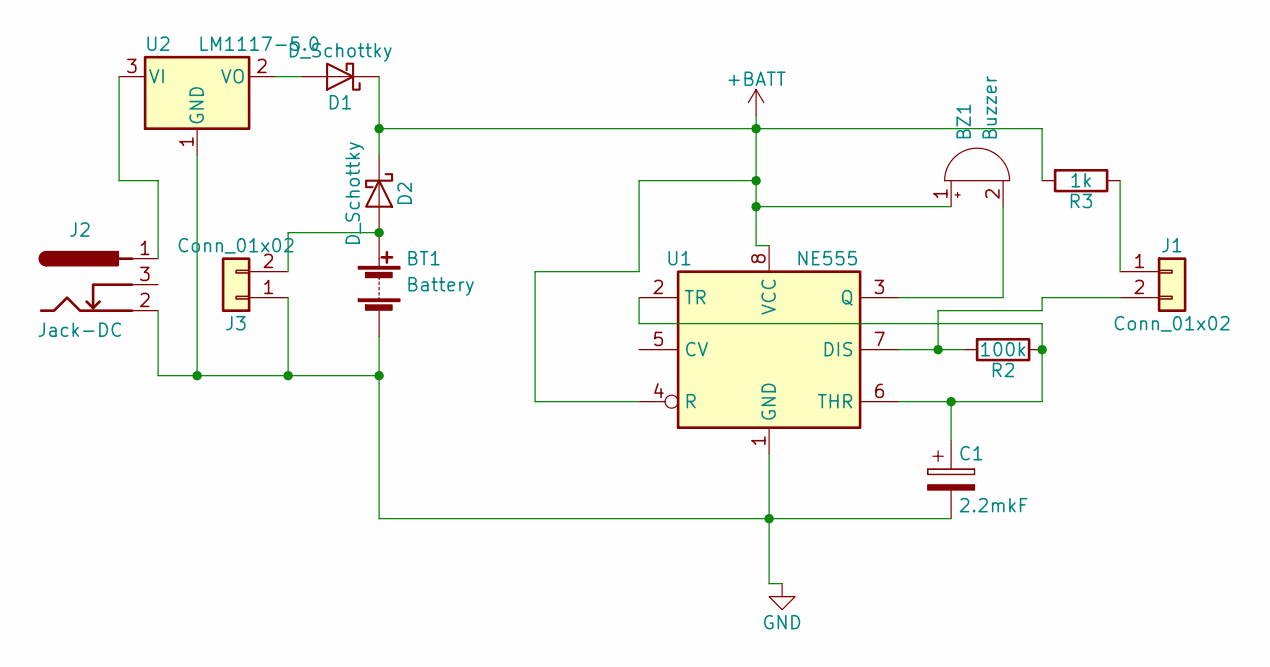
[picture p18: schematic v01.sch]

Parts:
BT1: Battery; Keystone_2479_3xAAA
BZ1: Buzzer; Buzzer_12x9.5RM7.6
C1: 2.2mkF; CP_Radial_D5.0mm_P2.50mm
D1, D2: D_Schottky; D_SMB_Handsoldering
J1, J3: Conn_01x02; Pin_Header_Straight_1x02_Pitch2.54mm
J2: Jack-DC; JACK_ALIM
R2: 100k; R_1206_HandSoldering
R3: 1k; R_1206_HandSoldering
U1: NE555; SOIC-8_3.9x4.9mm_Pitch1.27mm
U2: LM1117-5.0; SOT-223

Connections:
+BATT: BZ1.1 (-), D1.1 (K), D2.1 (K), R3.2, U1.4 (R), U1.8 (VCC)
GND: BT1.2 (-), C1.2, J2.2, J3.1, U1.1 (GND), U2.1 (GND)
unnamed: BT1.1 (+), D2.2 (A), J3.2
unnamed: BZ1.2 (+), U1.3 (Q)
unnamed: C1.1, R2.1, U1.2 (TR), U1.6 (THR)
unnamed: D1.2 (A), U2.2 (VO)
unnamed: J1.1, R3.1
unnamed: J1.2, R2.2, U1.7 (DIS)
unnamed: J2.1, U2.3 (VI)

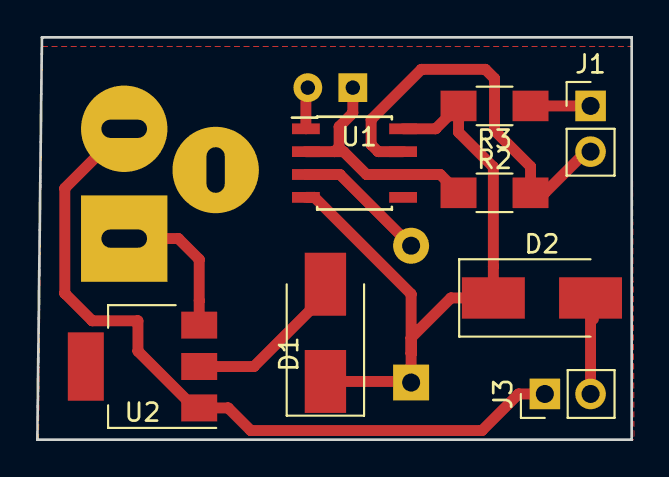
[picture p19: board leakage_sensort/v01.kicad_pcb from above]

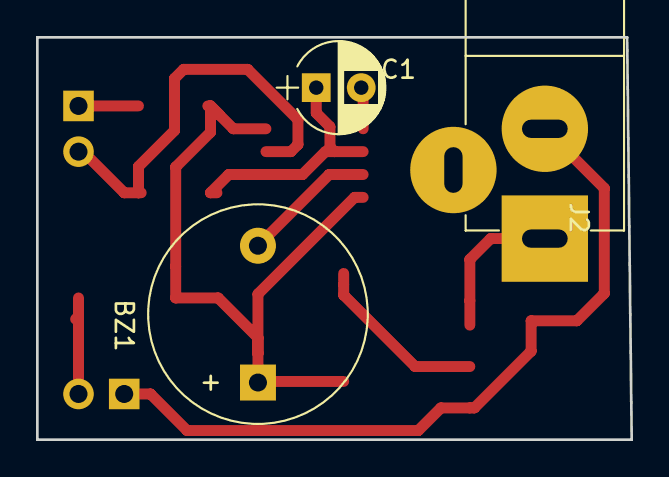
[picture p20: board leakage_sensort/v01.kicad_pcb from below]

Board: 2 copper layers, 33.0 x 22.4 mm, 11 parts (3 on the bottom side), 9 nets.
