amiguser/pcb/pcb2produce/v-01.kicad_pcb

## KiCad design pcb2produce/v-01.kicad_pcb (2018-08-03)

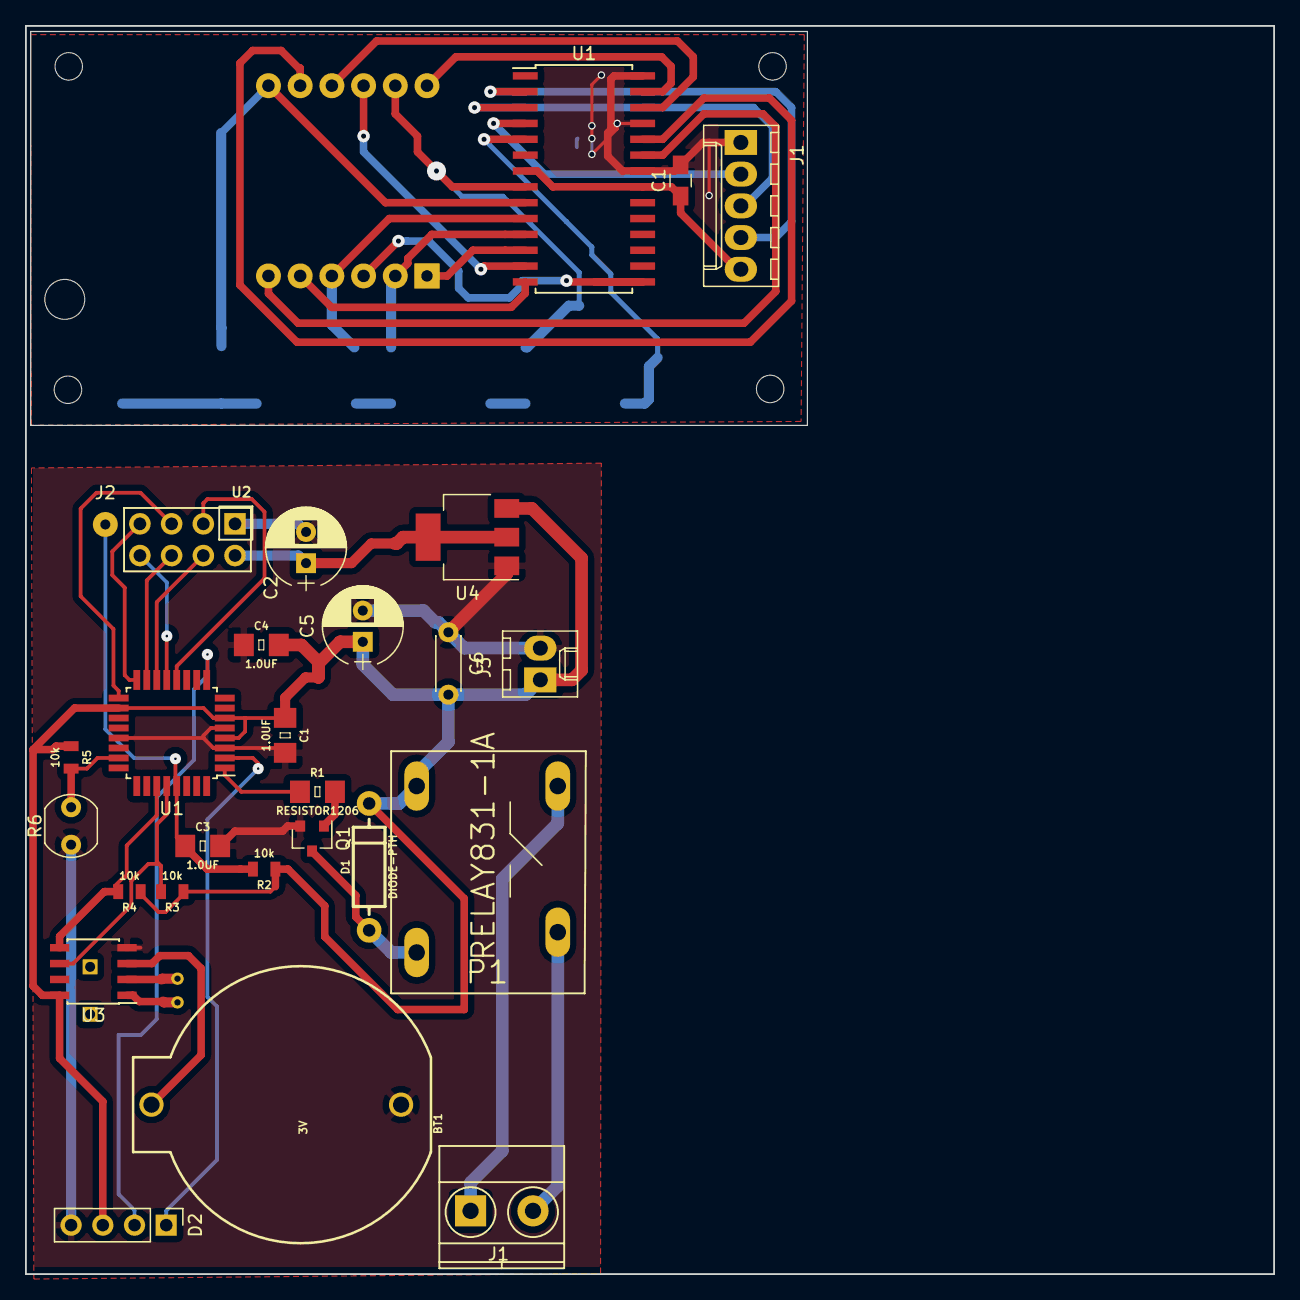
[picture p21: board v-01.kicad_pcb from above]

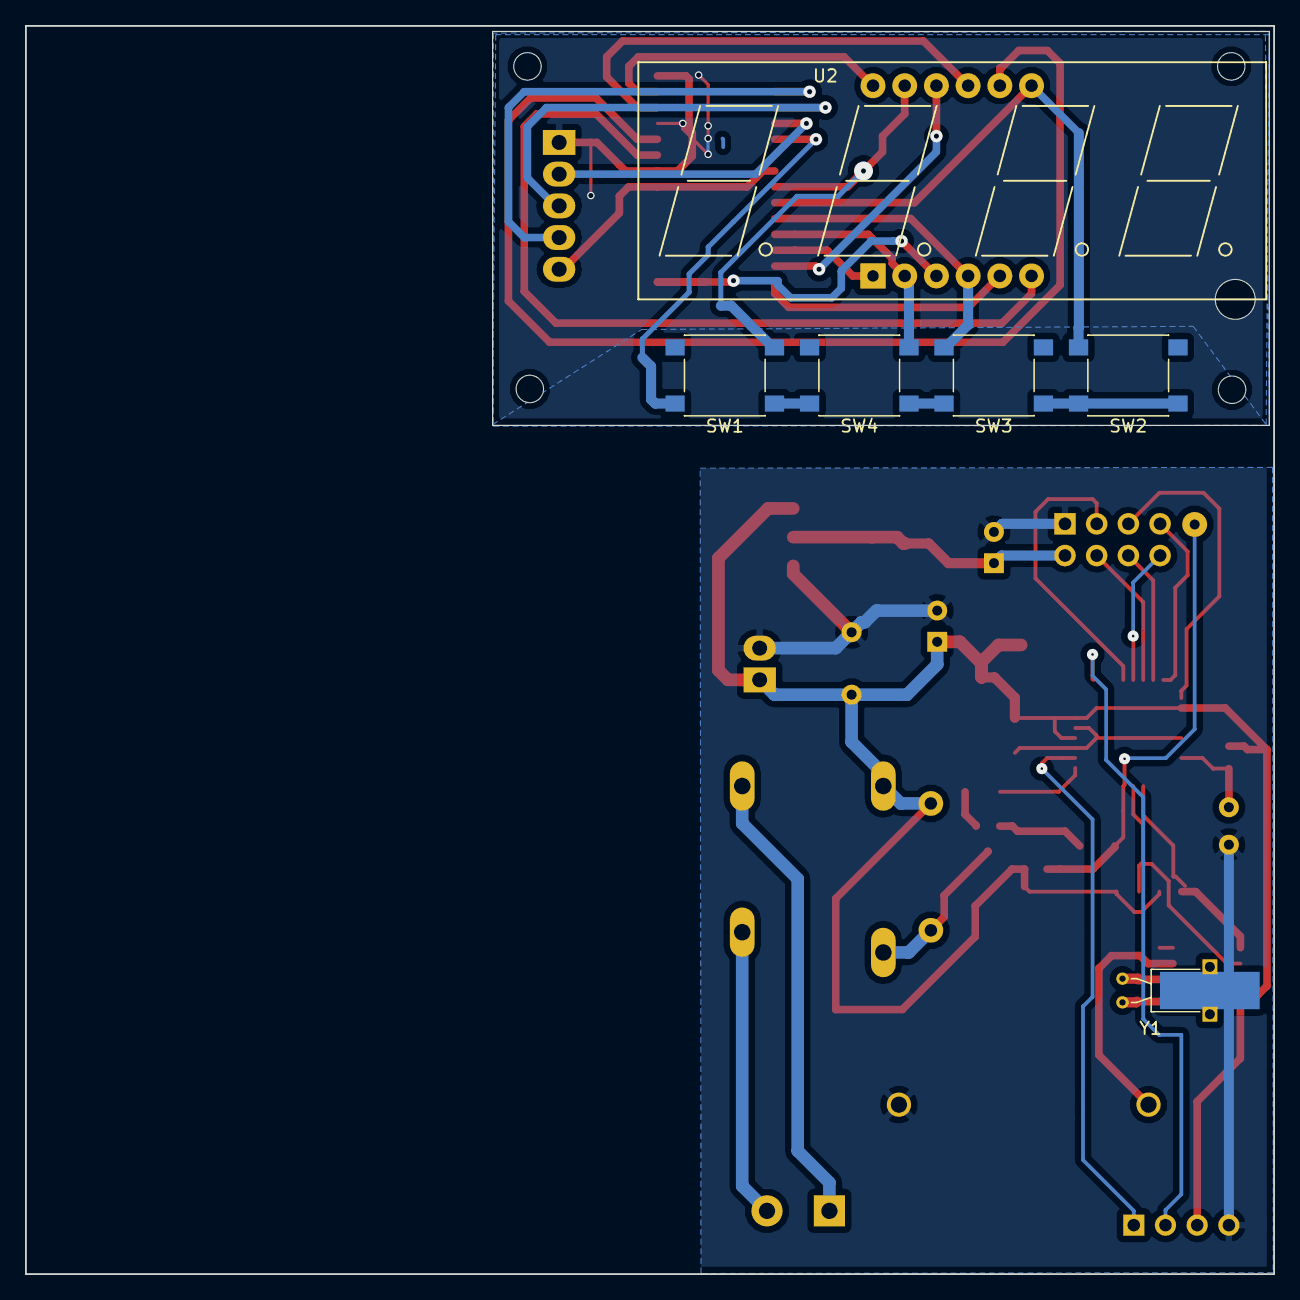
[picture p22: board v-01.kicad_pcb from below]

Board: 2 copper layers, 100.0 x 100.0 mm, 33 parts (6 on the bottom side), 41 nets.

Parts:
BT1: 3V; BATTCOM_20MM_PTH
C1, C3, C4: 1.0UF; 1206
C1#2: 0.1; C_0805_HandSoldering
C2: 22mF; CP_Radial_D6.3mm_P2.50mm
C5: 470mF; CP_Radial_D6.3mm_P2.50mm
C6: 1.0UF; C_Disc_D4.3mm_W1.9mm_P5.00mm
D1: DIODE-PTH; DIODE-1N4001
D2: TM1637Module; Pin_Header_Straight_1x04_Pitch2.54mm
J1: Screw_Terminal_01x02; TerminalBlock_Pheonix_MKDS1.5-2pol
J1#2: Conn_01x05; Molex_KK-6410-05_05x2.54mm_Straight
J2: CONN_01POGOPIN_HOLE_0.58; SolderWirePad_single_0-8mmDrill
J3: +5DC; Molex_KK-6410-02_02x2.54mm_Straight
P1: RELAY831-1A; Relay-841-1A
Q1: BC847; SOT-23
R1: RESISTOR1206; 1206
R2, R3, R4, R5: 10k; 0805
R6: A9013; Resistor_LDR_5x4.1_RM3
SW1, SW2, SW3, SW4: SW_Push; SW_SPST_PTS645
U1: ATMEGA8-16AU; TQFP-32_7x7mm_Pitch0.8mm
U1#2: TM1628; SOIC-28W_7.5x17.9mm_Pitch1.27mm
U2: NRF24L01
U2#2: CA56-12EWA; Cx56-12
U3: DS1307Z; SOIC-8_3.9x4.9mm_Pitch1.27mm
U4: LM1117 3v3; SOT-223
Y1: 32768; Crystal_C38-LF_d3.0mm_l8.0mm_Horizontal_1EP_style2

Connections:
+5VD: C1.1, C4.2, C5.1, C6.2, D1.C, D2.3, J3.1, P1.1, R2.1, R3.1, R4.1, R5.1, U1.4, U1.6, U1.18, U3.8, U4.3
ADC0: R5.2, R6.2, U1.23
GND: BT1.2, C1.2, C1#2.2, C2.2, C3.2, C4.1, C5.2, C6.1, D2.4, J1#2.1, J3.2, Q1.2, R6.1, U1.3, U1.5, U1.21, U1#2.22, U1#2.25, U1#2.28, U2.1, U3.4, U4.1
K1: SW1.1, SW2.1, SW3.1, SW4.1, U1#2.5
MISO: U1.16, U2.7
MOSI: U1.15, U2.6
unnamed: BT1.1, U3.3
unnamed: C2.1, U2.2, U4.2, U4.4
unnamed: D1.A, P1.2, Q1.3
unnamed: J1.1, P1.3
unnamed: J1.2, J1#2.2, P1.4, U1#2.4
unnamed: J1#2.3, U1#2.3
unnamed: J1#2.4, U1#2.2
unnamed: Q1.1, R1.2
unnamed: U1.19, U1#2.19
unnamed: U1.20, U1#2.20
unnamed: U3.1, Y1.1
unnamed: U3.2, Y1.2
PB0: U1.12, U2.3
PB1: U1.13, U2.8
PB2: U1.14, U2.4
RESET: C3.1, J2.1, R2.2, U1.29
SCK: U1.17, U2.5
SCL: R3.2, U1.28, U3.6
SDA: R4.2, U1.27, U3.5
VCC: C1#2.1, J1#2.5, U1#2.7, U1#2.21
dig_0: U1#2.27, U2#2.12
dig_1: U1#2.26, U2#2.9
dig_2: U1#2.24, U2#2.8
dig_3: U1#2.23, U2#2.6
pd3: R1.1, U1.1
pd4: D2.1, U1.2
pd5: D2.2, U1.9
seg_a: SW1.2, U1#2.8, U2#2.11
seg_b: SW2.2, U1#2.9, U2#2.7
seg_c: SW3.2, U1#2.10, U2#2.4
seg_d: SW4.2, U1#2.11, U2#2.2
seg_dp: U1#2.15, U2#2.3
seg_e: U1#2.12, U2#2.1
seg_f: U1#2.13, U2#2.10
seg_g: U1#2.14, U2#2.5
