amiguser/pcb/weatherStation.X/lcdtwi.h

#ifndef LCDTWI_H_
#define LCDTWI_H_

#include "main.h"

//----------------------------------------
void LCD_ini(void);
void setpos(unsigned char x, unsigned y);
void str_lcd (char str1[]);
void clearlcd(void);
void sendcharlcd(unsigned char c);
//----------------------------------------
#define e1   I2C_SendByteByADDR(portlcd|=0x04,0b01001110) // установка линии E в 1
#define e0   I2C_SendByteByADDR(portlcd&=~0x04,0b01001110)  // установка линии E в 0
#define rs1    I2C_SendByteByADDR(portlcd|=0x01,0b01001110) // установка линии RS в 1
#define rs0   I2C_SendByteByADDR(portlcd&=~0x01,0b01001110)  // установка линии RS в 0
#define setled()    I2C_SendByteByADDR(portlcd|=0x08,0b01001110) // включение подсветки
#define setwrite()   I2C_SendByteByADDR(portlcd&=~0x02,0b01001110)  // установка записи в память дисплея
//----------------------------------------


#endif /* LCDTWI_H_ */
