amiguser/pcb/(commit log)

2018-08-31 waterlock init
    [controller.kicad_pcb, controller.sch]
2018-09-07 firmware start
    [controller.kicad_pcb, controller.sch]
2018-12-05 new wave
    [controllerTFQP.sch, ds1307.sch, file5BFF3A0F.sch]
2018-12-23 input 5v
    [controllerTFQP.kicad_pcb]
